litel-ufjf/CentralDeBombas/documentos/figuras/comparativo_curvas_medias.png

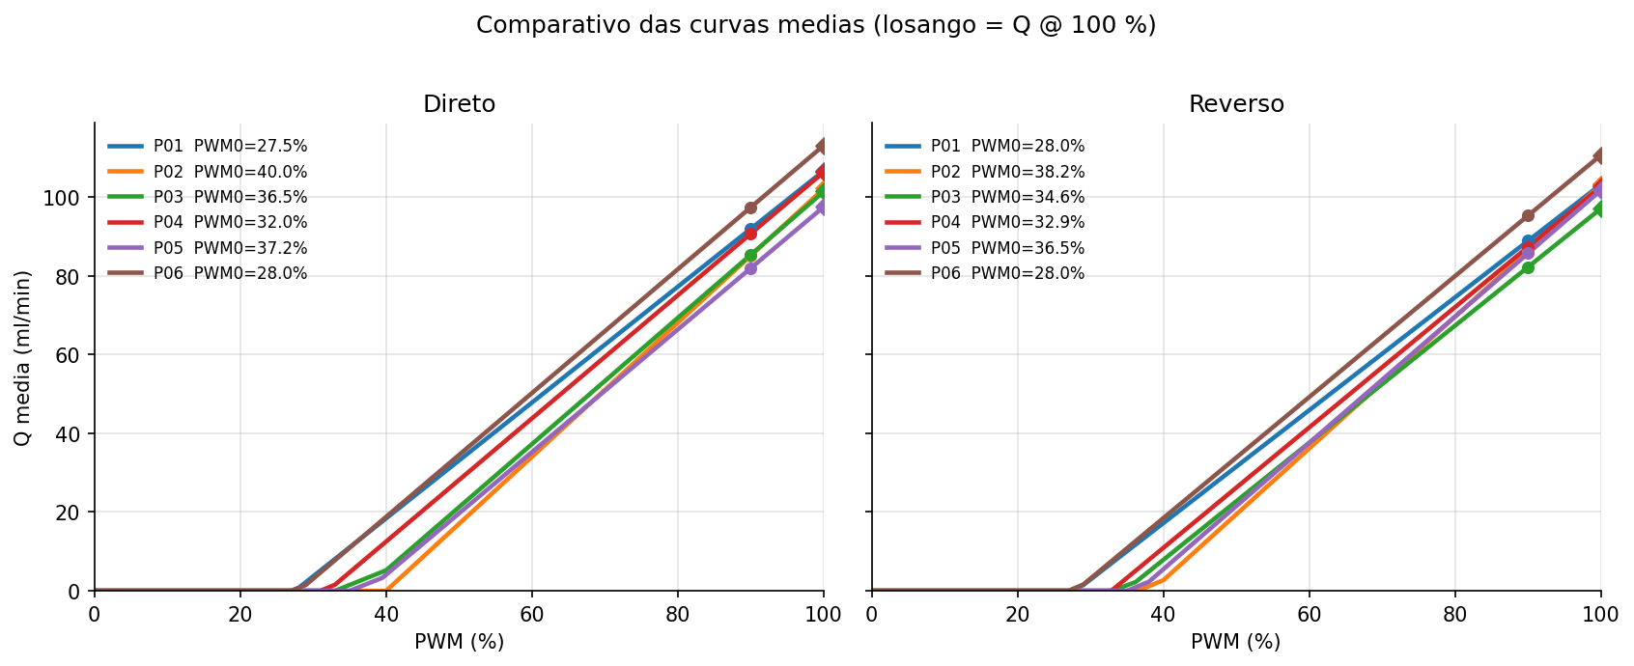
documentos/figuras/comparativo_curvas_medias.png
