litel-ufjf/CentralDeBombas/documentos/figuras/comparativo_seis_bombas.png

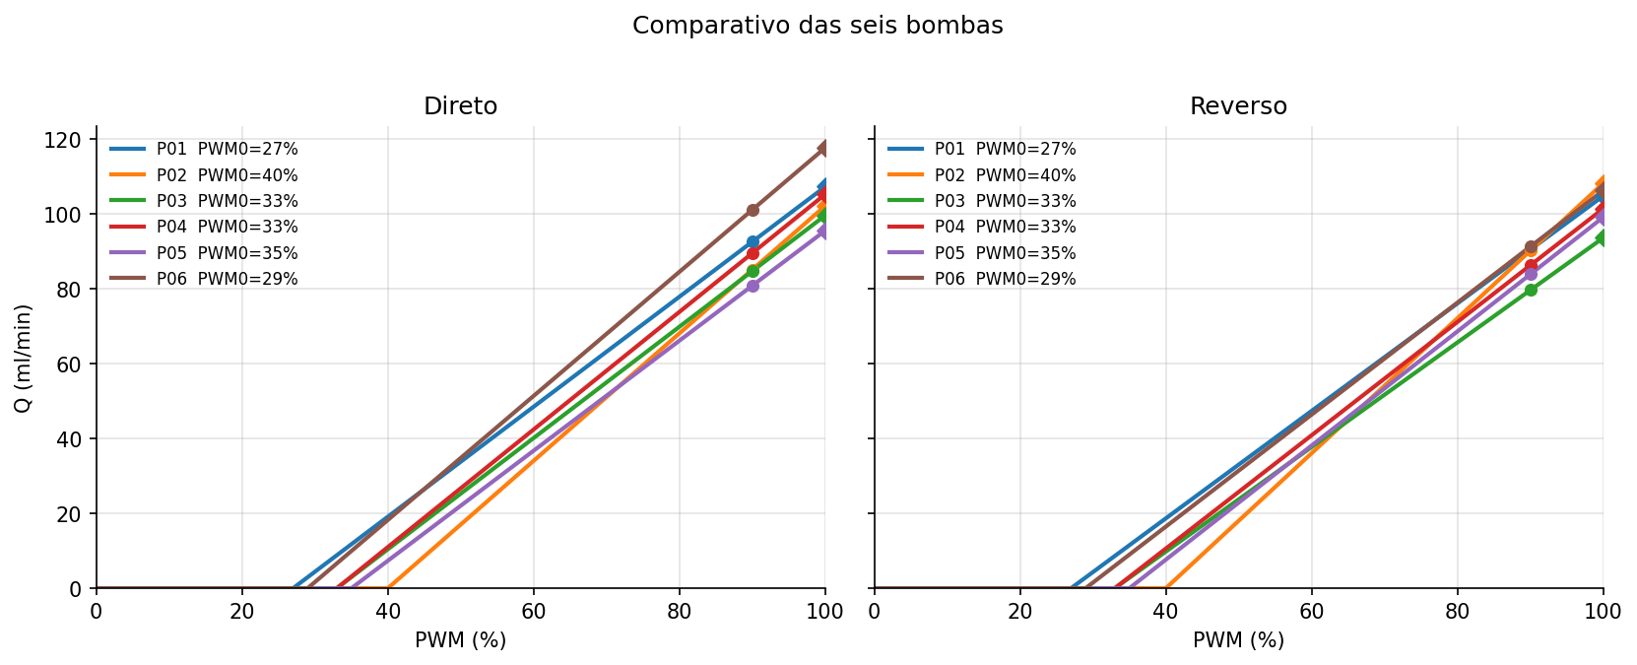
documentos/figuras/comparativo_seis_bombas.png
