litel-ufjf/CentralDeBombas/documentos/figuras/curvas_media_por_bomba.png

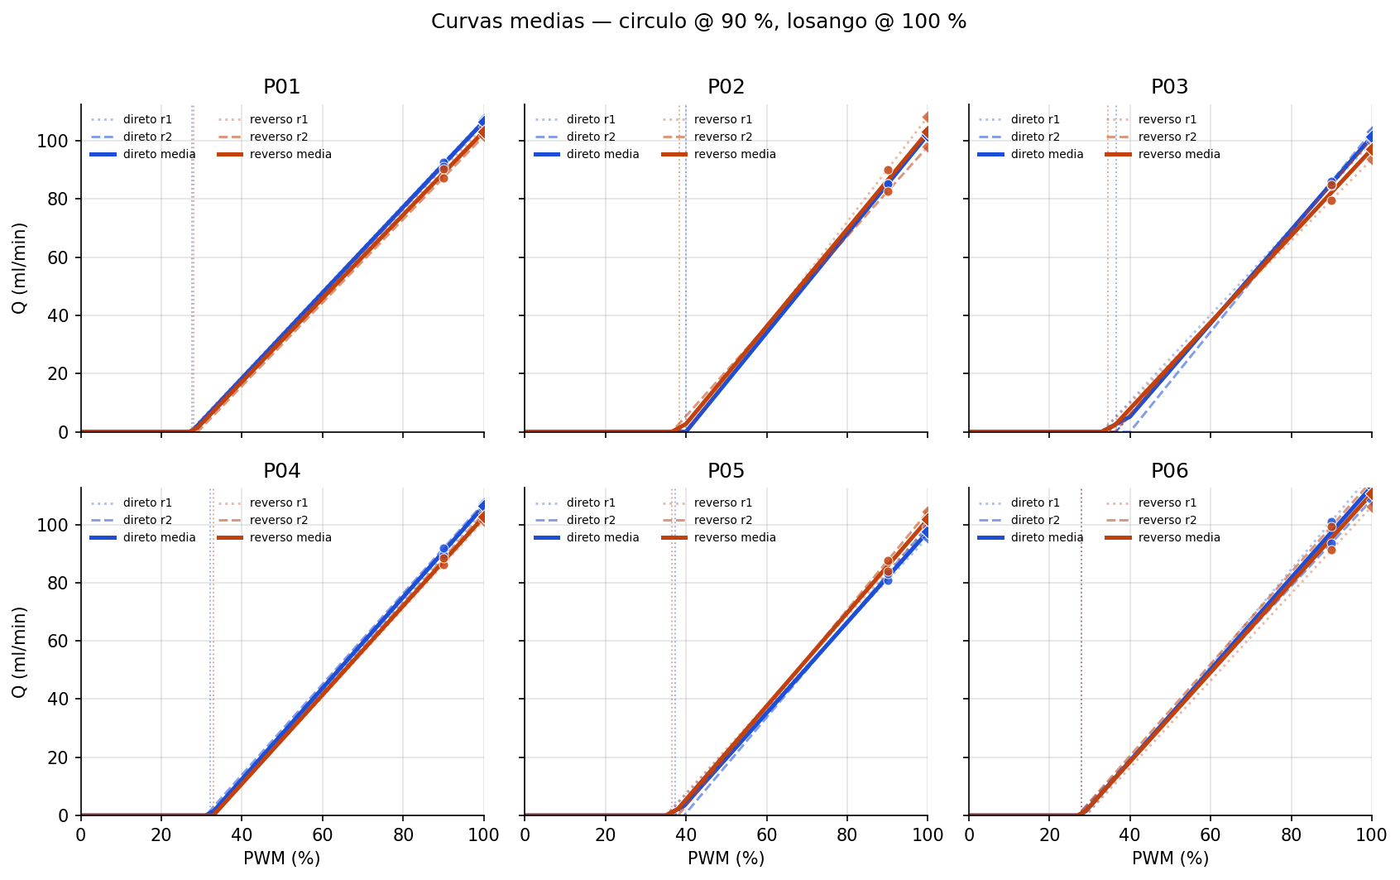
documentos/figuras/curvas_media_por_bomba.png
