litel-ufjf/CentralDeBombas/documentos/figuras/curvas_por_bomba.png

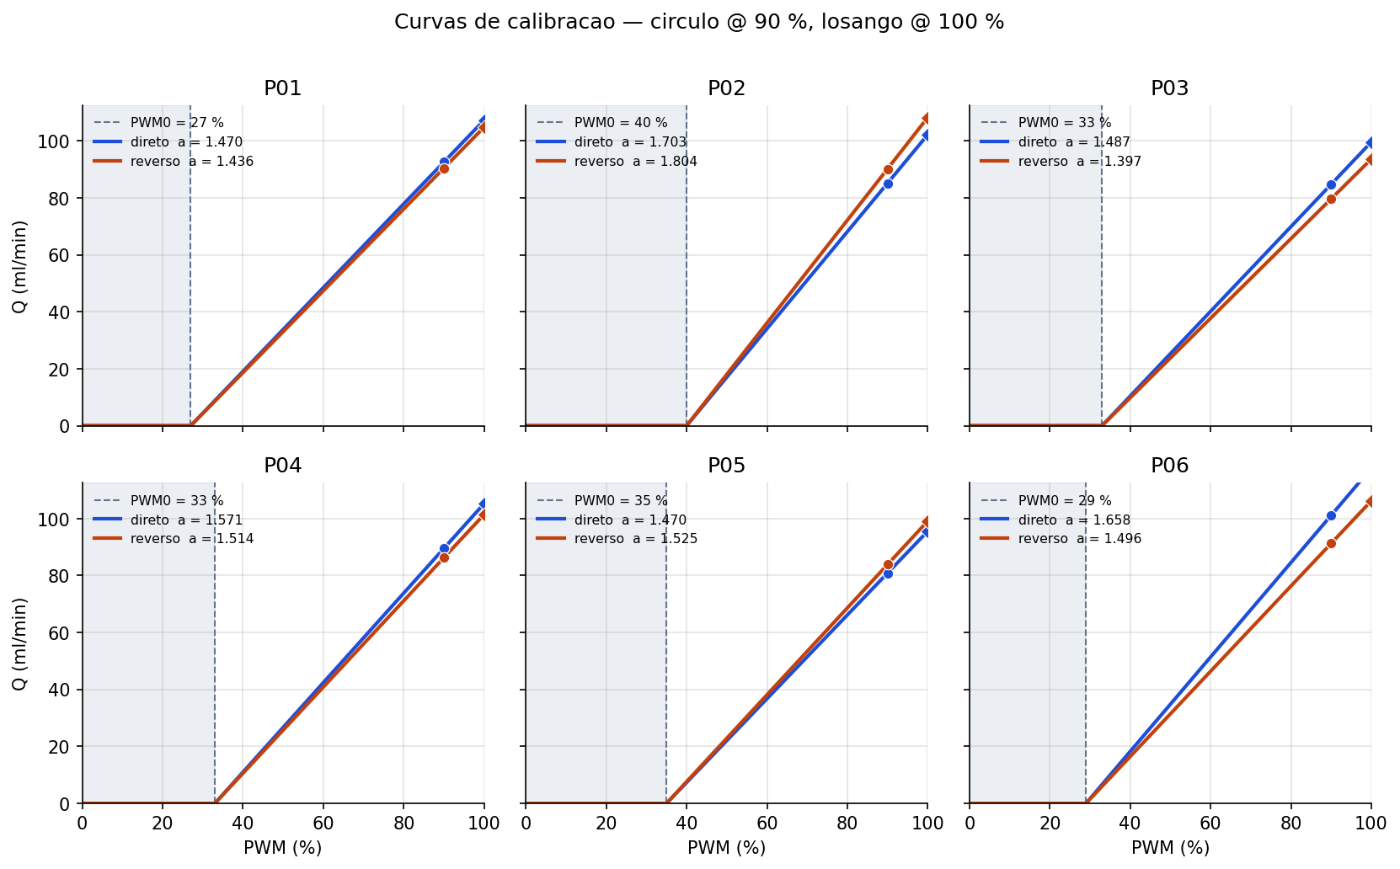
documentos/figuras/curvas_por_bomba.png
