litel-ufjf/CentralDeBombas/documentos/figuras/pwm0_e_assimetria.png

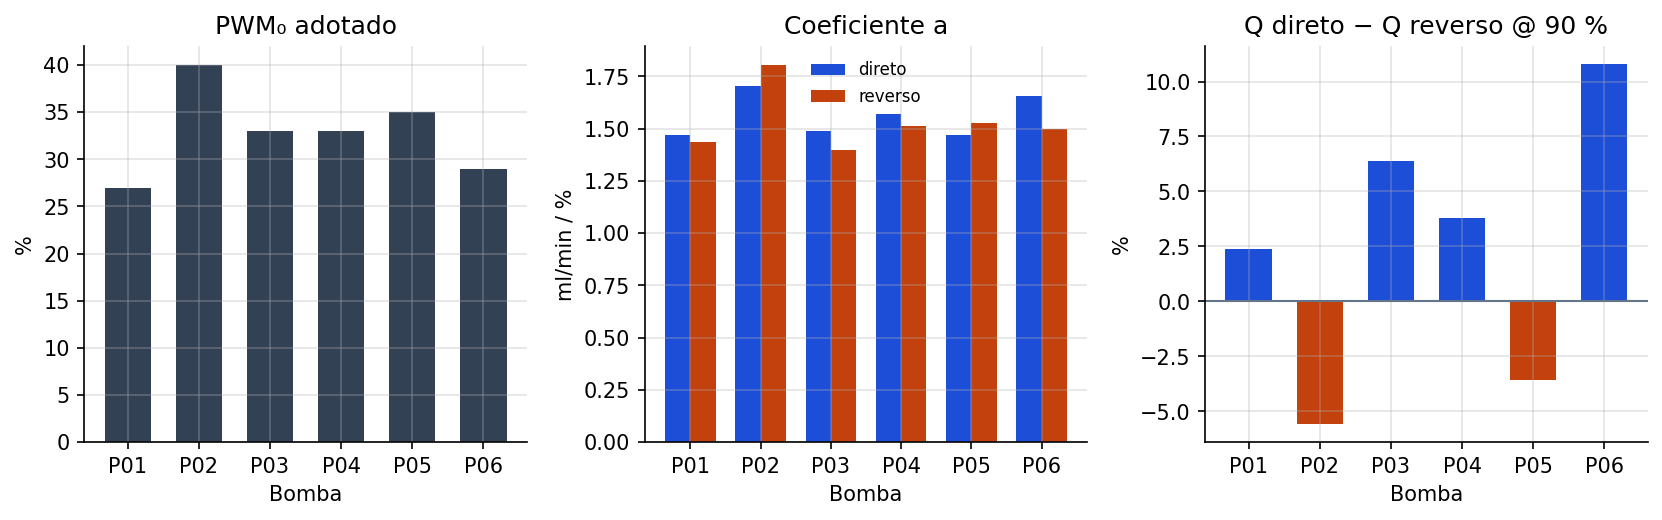
documentos/figuras/pwm0_e_assimetria.png
