litel-ufjf/CentralDeBombas/documentos/figuras/repetibilidade_duas_rodadas.png

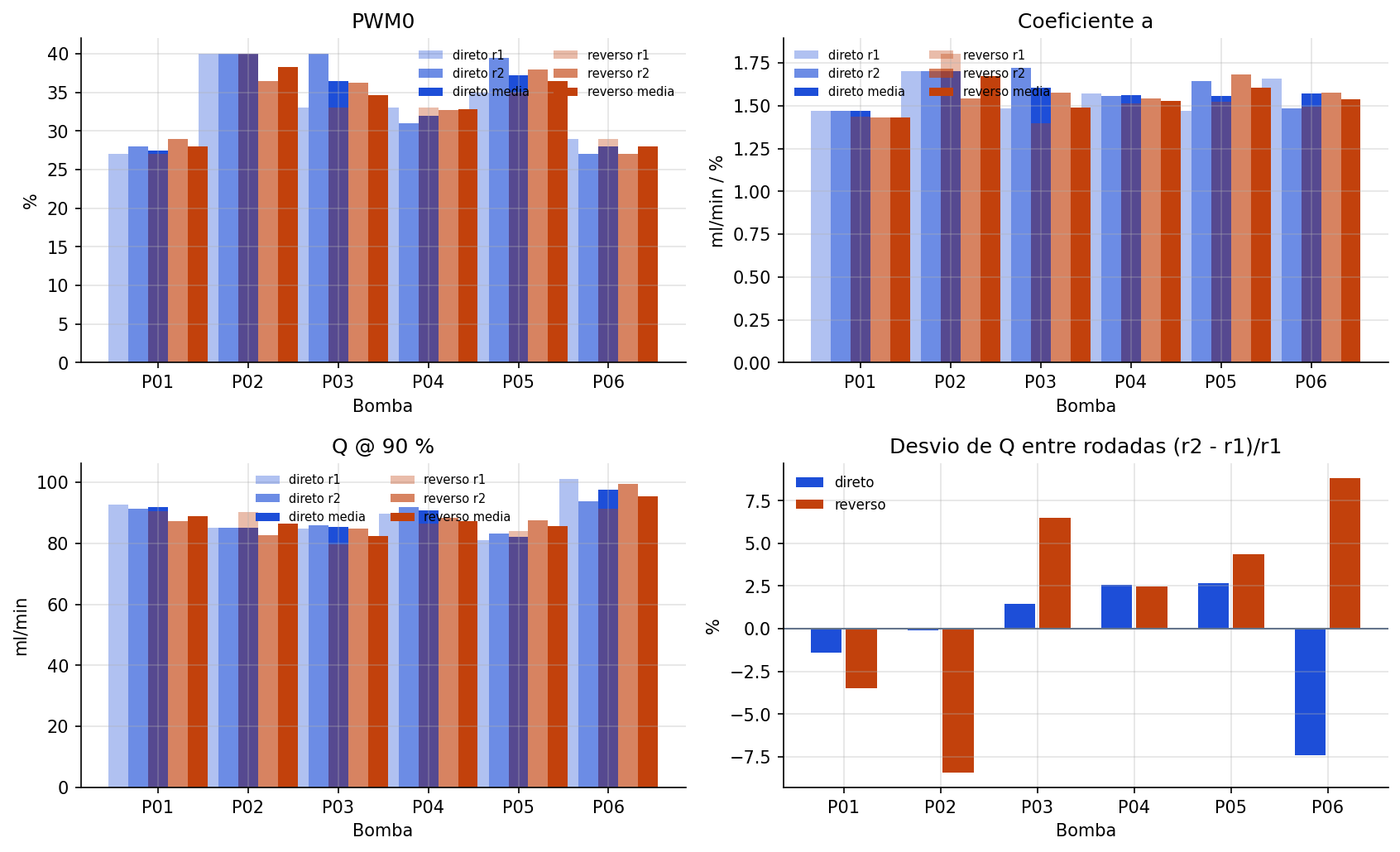
documentos/figuras/repetibilidade_duas_rodadas.png
