litel-ufjf/CentralDeBombas/scripts/referencia_blocos/comparacao_final.png

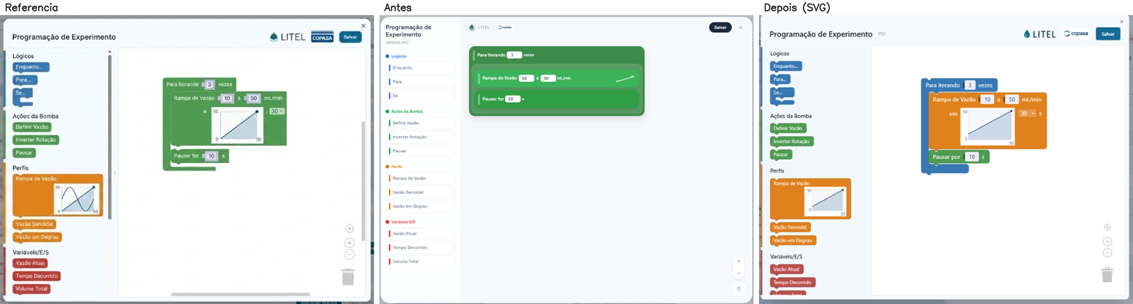
scripts/referencia_blocos/comparacao_final.png
