litel-ufjf/CentralDeBombas/scripts/referencia_blocos/referencia.png

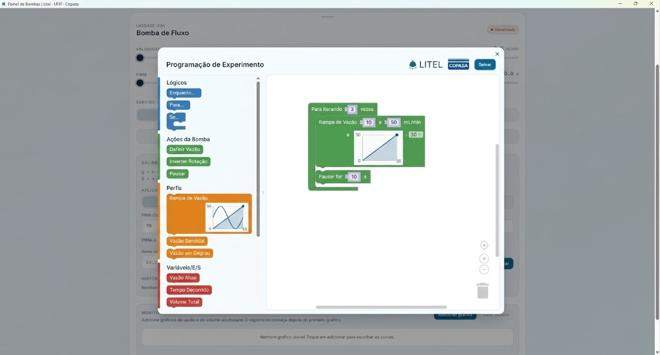
scripts/referencia_blocos/referencia.png
