litel-ufjf/CentralDeBombas/(commit log)

2026-09-20 Imagem de exemplo
2026-09-22 Adiciona o ensaio de calibração por volume fixo ou tempo fixo em cada bomba.
2026-09-22 Sobe o Painel de Bombas para a versão 1.0.4.
2026-09-23 Persiste a calibração no SQLite local e adiciona o menu de configurações.
2026-09-23 Expõe o PWM₀ no ensaio de calibração e registra a metodologia e as curvas dos ensaios em notebook.
    [ensaios_calibracao.csv]
2026-09-24 Registra a segunda rodada de calibração e as curvas médias das duas campanhas.
    [ensaios_calibracao_rodada2.csv]
2026-09-24 Documenta em PDF a calibração das bombas com as duas campanhas de bancada.
2026-09-28 Separa em abas o ensaio Calibrar e os parâmetros de zona morta, e sobe para a versão 1.0.7.
2026-09-29 Empacota o instalador fora de Documents no npm run build, evitando o bloqueio do Windows ao renomear win-unpacked.
2026-09-29 Redesenha em SVG os blocos da Programação de Experimento, no estilo do Blockly e próximos da referência visual.
2026-09-29 Adiciona scripts de captura e comparação por visão computacional do modal de blocos com a referência.
2026-09-29 Adiciona o firmware interface_prog, que sincroniza o relógio com o computador e executa programas de bombas na hora ou em horário agendado, com pausa e parada.
2026-09-29 Lê a entrada do serial-host em blocos de 4 KB para enviar programas longos sem atraso.
2026-09-29 Envia a programação das bombas para a placa, com início imediato ou agendado, acompanhamento, pausa e parada confirmadas por um diálogo que pode deixar de ser exibido.
2026-09-29 Minimiza o editor de programação em um painel flutuante que acompanha as programações em execução, agendadas ou pausadas em qualquer tela.
2026-09-29 Sobe para a versão 2.0.0, com a programação de experimentos funcional, e atualiza o README.
2026-09-29 Considera o sentido de rotação nos gráficos de vazão e volume, com volume inicial por bomba e a opção de manter o comportamento anterior em Configurações.
2026-09-30 Mostra mini-gráficos também nos perfis senoidal e em degrau da paleta de blocos.
2026-09-30 Editor de programação: tela cheia, nome com salvamento automático, biblioteca interna, exportar e abrir arquivos.
2026-09-30 Variáveis como blocos de valor encaixáveis, bloco de comparação para Enquanto/Se (firmware PROG2) e desfazer/refazer no editor com Ctrl+Z/Ctrl+Y.
2026-09-30 Acrescenta = e ≠ nas comparações, senão no bloco Se, o bloco Escolha/caso e a variável Sentido (firmware PROG3).
2026-09-30 Acrescenta os operadores lógicos e, ou, ou exclusivo e não às condições de Enquanto/Se (firmware PROG4).
2026-09-30 Habilita F11 para alternar a tela cheia em todo o app.
2026-09-30 Sobe para a versão 2.1.0.
